Jumner/cubicFirmware/README.md

# Cubic

This is the repo where I store the code for Cubic. I'm using this README to document my process and share some of the engineering challenges I went through. So what is Cubic? Inspired by [Cubli](https://www.youtube.com/watch?v=n_6p-1J551Y), it is a cube that can balance on a corner or edge by spinning reaction wheels. Though it balances on the corner, there is always room to make it more robust. If I come back to this project, I will definitely do it right with Simulink, ROS and a chip with more than 2kb of ram. Also for the record, it doesn't jump up like the original, that would require a complete redesign.

<p align="center">
<b>Render<b>
render
VS
reality
<b>Reality<b>
</p>

## Viability Analysis (July 2021)

Before starting, I recognized that this was not going to be easy. I normally don't consider completion in software projects since the risk is zero. But if I'm buying hardware, I don't want it wasted when I could have done some basic math. So I started with some basic inverted pendulum equations and started playing with the values. How long should the sides be? How much torque does it need? How much inertia do my wheels need? Well, I defined these all as a function of side length. The torque due to gravity is proportional to mass and length or roughly length to the fourth. This incentives smaller cubes. With this in mind I wanted something around the 100-200mm range so I started at some motors, to see if I could find some with enough torque. After looking around and doing some math, I came to the conclusion that I could realistically pull this off.

### The Motors (August 2021)

I found Nidec24h Motors on eBay. They have fairly high rpm, high torque, built in tachometers, built in drivers. Knowing smaller cubes are better, I ran some numbers on the smallest cube I thought I could make with some rough estimates and found that it should work. Awesome! Let's get designing.

<p align="center">
Nidec24h BLDC Motor</p>

## Mechanical Design (October 2021)

With my motors picked, I started on the CAD. It was entirely designed with Fusion360 and I started by laying the motors out so they were basically touching. From there, I made the wheels so that they were almost touching (larger wheels is more inertia == higher impulse before the motors reach their peak rpm). I surrounded the wheels with a 150mm frame box. From there I made the motor mounts. I found that they all intersected with each other since the wheels are so large. So I decided to make an inner frame and outer frame. Kind of like a tesseract shape. This was a really great decision. Here you can see a basic design I made before picking the motors and one from before I increased the wheel size. I then added the white TPU bumpers which increased the size to 155mm.

<p align="center">
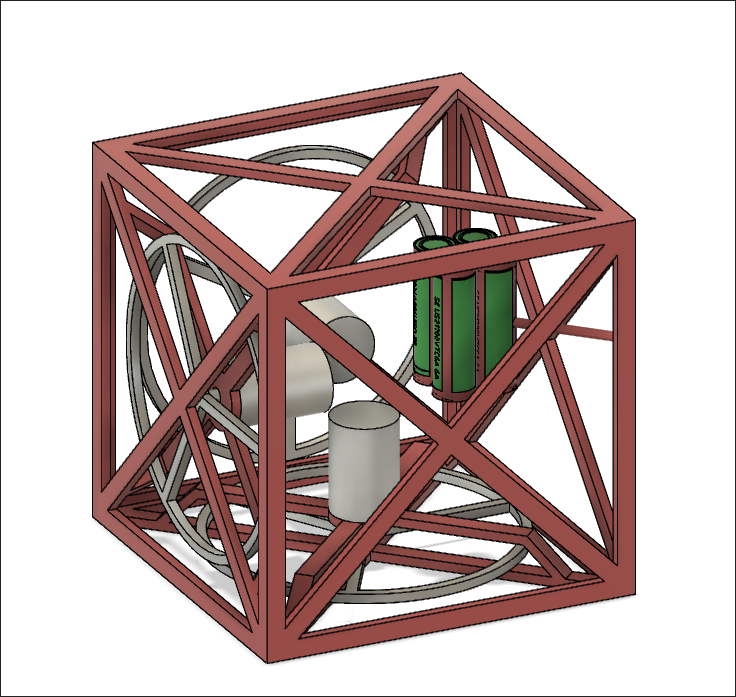
[picture p1: images/redbox.png]
Early render

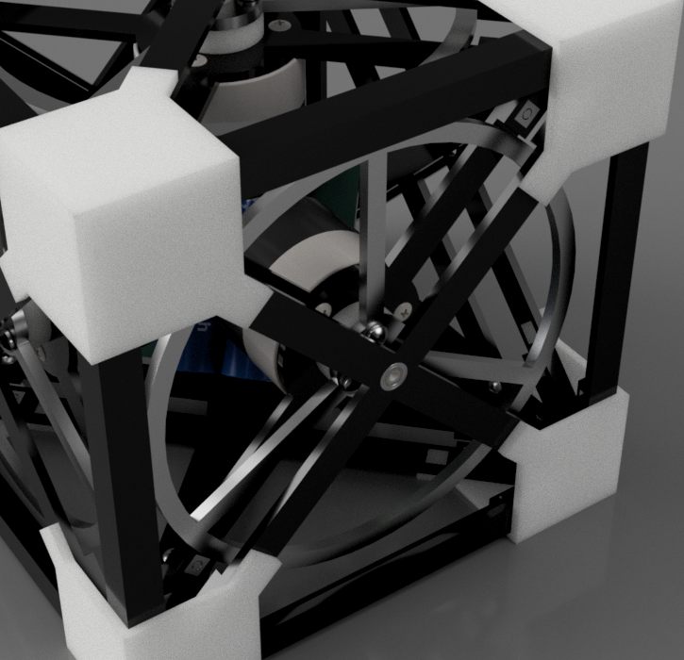
[picture p2: images/earlyrender.png]
More fleshed out render

</p>

### Wait 155mm??

Hold on a second... I plan on 3d printing this since that's the only manufacturing technique I really have. The problem is that my 3d printer has a print volume of 120mm x 120mm x 120mm. So I need to design this thing so that no part is larger than that.

The way I accomplished this is by splitting it into a bunch of parts with dovetails and fasteners. The inner frame is thankfully barely smaller than 120mm so those can be printed in one peice. Then I made these intricate corner pieces that bolt to the inner face, have each half edge click on, and have each face click on (with additional bolts). I then made these TPU covers for damping as I knew it would fall a lot. They also cover up the ugly corner joints. Here you can see the final design. A lot of time went into this, the final design in CAD is over 100 revisions.

<p align="center">
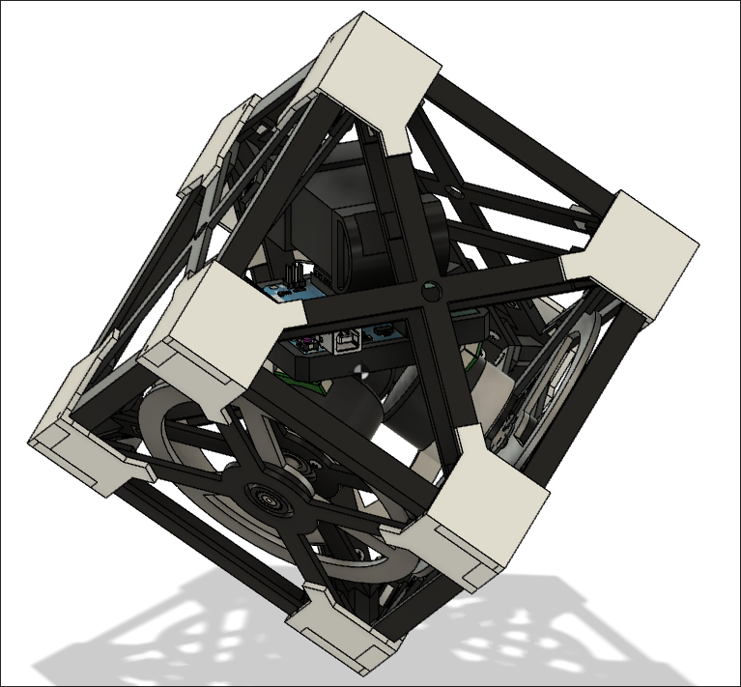
[picture p3: images/finaldesign.png]
Final design

</p>
You can see the complexity in these corner parts.
<p align="center">
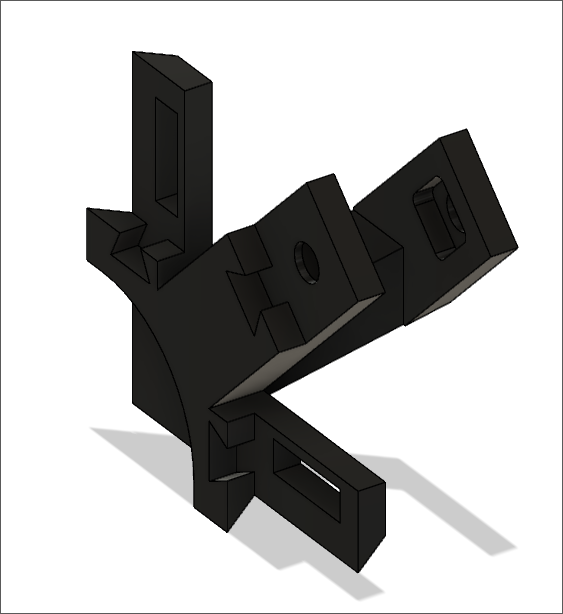
[picture p4: images/cornerpeice.png]
Corner piece

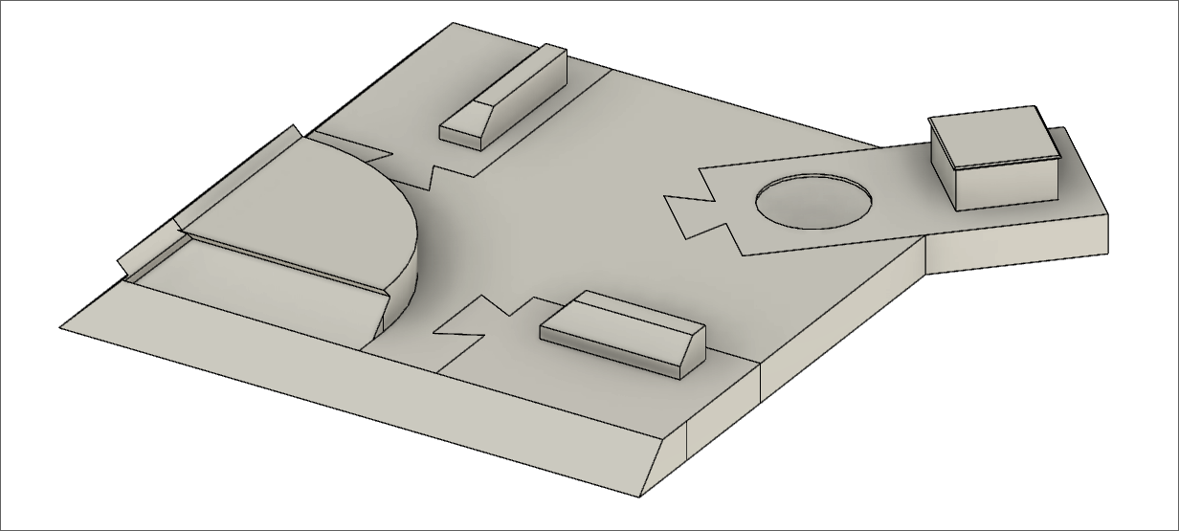
[picture p5: images/tpubumper.png]
TPU Bumper

</p>
And you can see how everything fits together to make a functional corner here.
<p align="center">
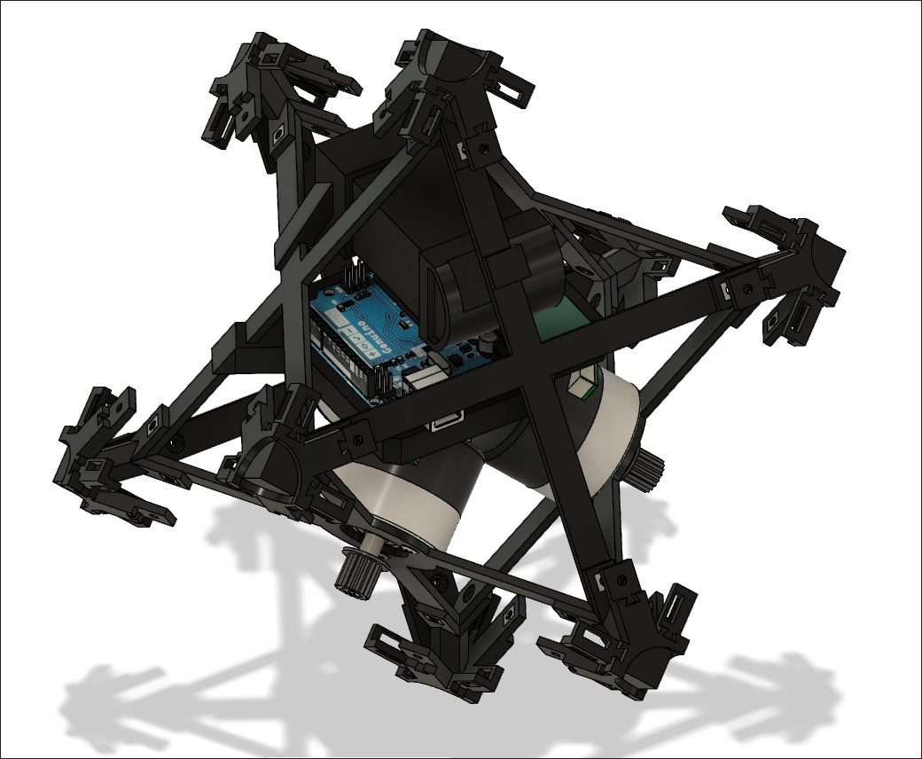
[picture p6: images/innercore.png]
Inner core assembly

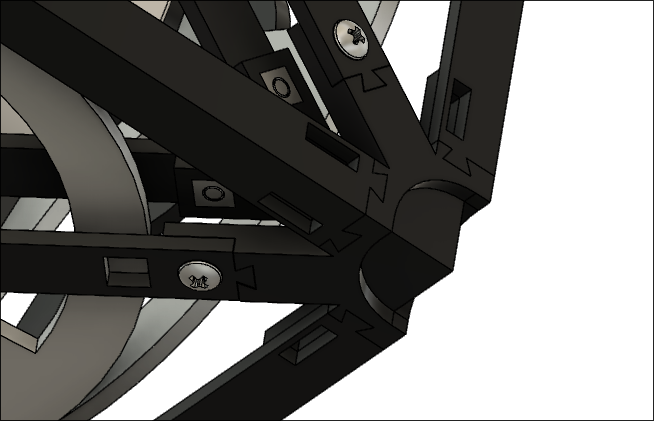
[picture p7: images/cornerassembly.png]
Corner assembly

</p>

### Nothing Ever Goes to Plan

I thought about having a small bearing click onto the end of the shaft so the motor and wheels are supported at 2 points, improving rigidity and reducing vibrations. However, there is a problem. I don't have my motors yet and I'm not sure if my motors have the pulley attached or if they just have the bare shaft. If they have the pulley, it is not going to work. Well, I took a gamble and started printing. Once the motors arrived, they had the pulleys which were intersection fit on and not coming off. I switched gears and reprinted the face so it would support the pulleys and remade the wheel mount. This was not ideal but it seemed to work.

### The Wheels (November 2021)

Once I did some more calculations and realized the wheels needed MUCH more inertia, I made them thicker and got them plasma cut out of 304L stainless steel at a local shop. These were perfect and make the project look so much more professional.

#### The Wheel Mounts

After discovering that the motors have pulleys, I designed a part to fit onto the pulley. The problem is that the tolerances to create a slip fit quickly wear and become loose. In hindsight, the holes could have been made undersized and inserted with the help of a heat gun. I ended up using white glue and tape to hole them in place. Far from ideal.

### Final Assembly (December 2021)

Now that I finally had all the parts, I could actually assemble them together! This when it started to feel real. It was super validating to see the mechanical design work out.

<p align="center">
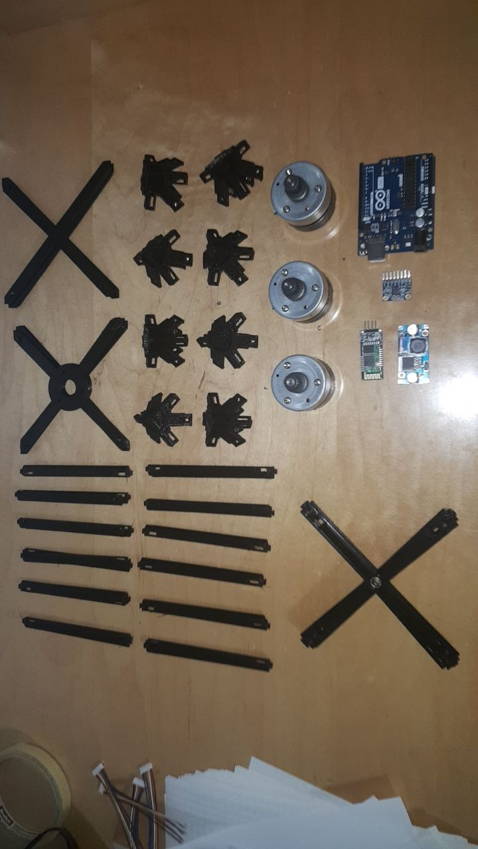
[picture p8: images/parts.jpg]
Parts

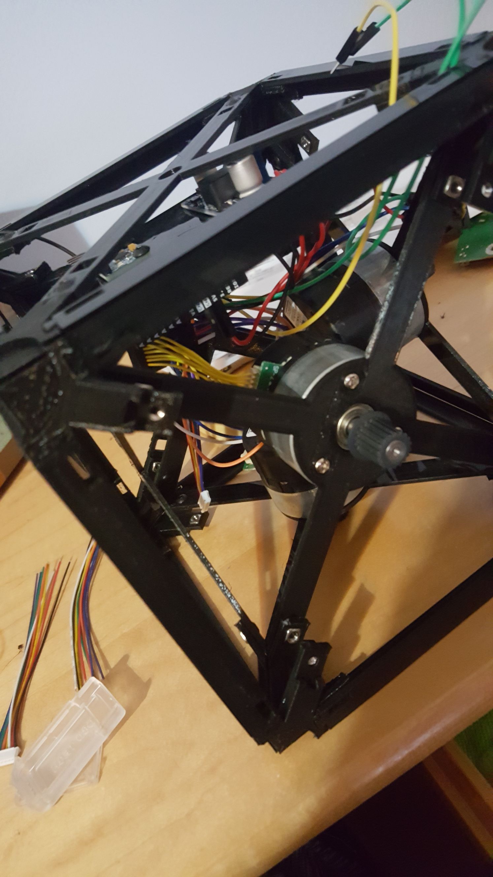
[picture p9: images/finalassemblynowheels.jpg]
Assembly with no wheels

reality
</p>

#### Happy Accidents

When I designed it, the corners would be glued together and it would be disassembled by unbolting everything. What I found is that Each face can stay together and all the faces can click together using the alignment features I put in the corners for gluing. This is far better in every possible way. A neat side effect is that my damping and decorative corner pieces now have the structural task of holding all the faces together. This makes servicing it super easy, just pop off 4 corner covers, pop 4 corners apart and removed just one face. The rest stay together. This is a great system and I got really lucky that I designed it in a way that allowed for this.

## Electronics

### The Printed Circuit Board Incident (September 2021)

The first real "failure" of the project (if you must call it that). I wanted to make my own circuit board as I have wanted to learn how to do that for some time. So I picked a chip (esp32) and spent a week reading datasheets, making the schematic and laying out the board. It included everything I needed including the MPU6050 inertial measurement unit that I would use to measure angles. So I ordered the boards and their components. I souldered the board and realized that even though I made extra sure the PCB traces could support the currents, I completely overlooked the power ratings of the components in my power supply circuitry. However, at least I could detect the chip from my computer, which was where I expected the board to fail. Regardless, this was not going to work.<br>

<p align="center">
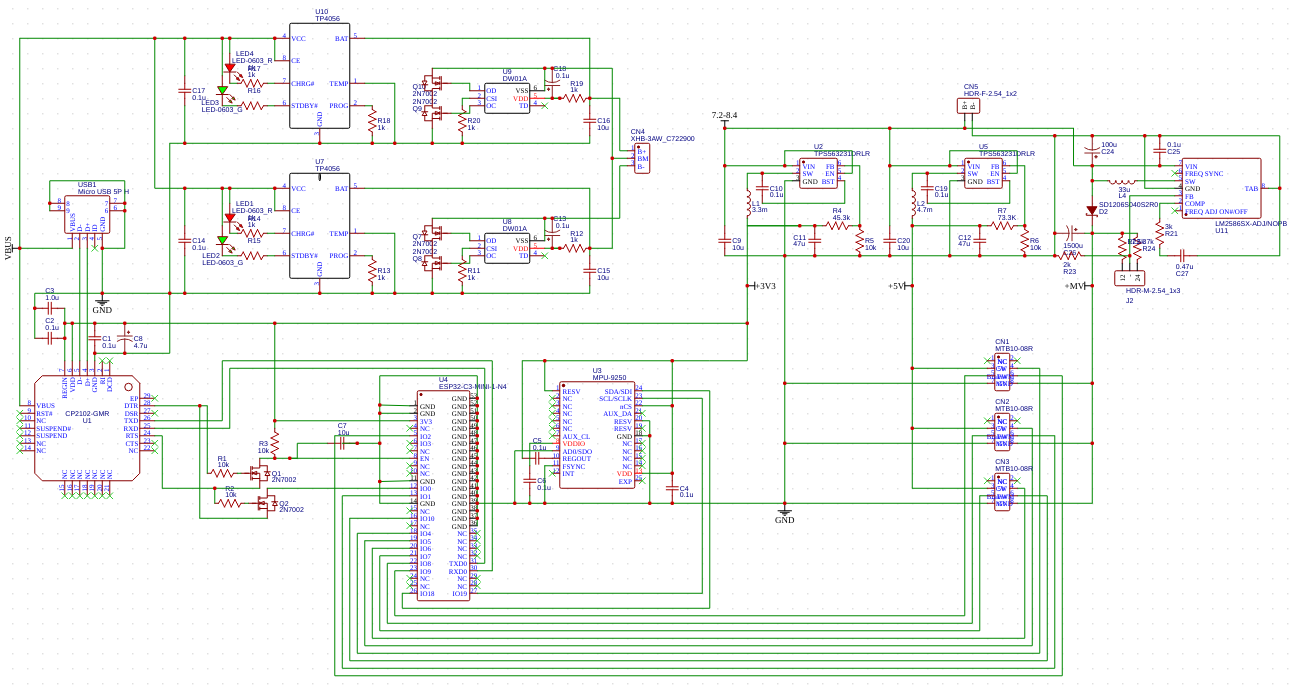
[picture p10: images/schematic.png]
PCB Schematic

</p>
<p align="center">
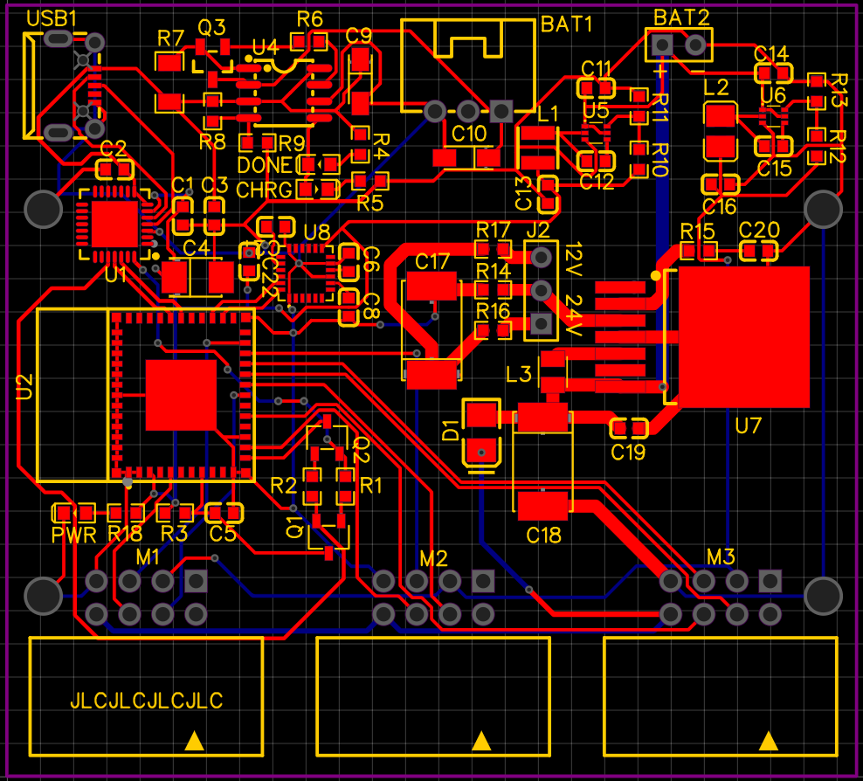
[picture p11: images/pcb1.png]
PCB layout

Final board
</p>
<br>
I should have realized just by looking at it that the components were too small (look at those tiny components in the top right of the board). Regardless, it was an amazing experience and I learned so much about electronics.

### Plan B

After my custom PCB went up in smoke (No, literally), I pivoted to using an Arduino Uno I had on hand. I then ordered a battery, step down buck converter, and an MPU6050 (mine was on the board remember?).

Using these I got the motors spinning after a quick panic about how the 12 or 24v motors accept EITHER 12 or 24 not a range so my old 18v laptop power supply would not work. After creating the now inevitable mess of wires, I had everything talking to the Arduino.

## Software

Wow! I've done so much! I must be at least halfway done right? Right? I just have to write some code. How hard can it be? Well with all the planning I did with the hardware, I did not once consider that maybe I should plan out the software too. Unfortunately this was my biggest mistake and probably one of the biggest lessons I learned, after all it cost me nearly 2 years of struggling when I could have spend a week planning.

Here begins a 2 year long game of guess and check.

### Rust (November 2021)

I love Rust. It's an amazing language. I wont even diss it here because I learned an incredible amount about embedded programming and microcontrollers in the week it took me to get I2C, PWM, and interrupts working (things that are a few lines of code in arduino). The problems came because the atmega328p does not have enough hardware interrupt pins for my 3 tachometers, and IMU (an interrupt was needed for the mpu6050s Digital Motion Processor which I ended up not using). Arduino just pretends it's fine and it somehow works. I have no idea what black magic Arduino does to get this to work but I gave up on Rust.

### Start with an Edge (January 2022)

Instead of jumping into balancing on the corner, I made the correct decision to start with the edge and use what I learned for the corner. However, this was no easy task and took months on its own.

<br>
<p align="center">
Cubic balancing on its edge
</p>

### Bottomless Pit of Controls (January 2022 - July 2023)

It was at this point that I started getting close, I experimented with everything I possibly could given the scope. The real problem was my uncertainty caused by the inability to collect data. If I could analyze data it would probably have taken me a tenth of the time. This is the endless game of guess and check I mentioned earlier. I took lots of breaks (including all of first year) and would come back with fresh ideas in my heads to finally get it balancing for real this time. The real demon here is the silicon shortage as I could not get a Pi zero 2. If I could, I could run ROS2 on it and get actual data. However, the best I could do is just run a serial cable directly and hope the cable doesn't affect its behaviour too much.

## The Journey of System Architecture

This was a long path of slowly finding the correct algorithms and discovering constraints I had no idea existed. Here are all the major systems and the path I took to arive at them.

### Big Picture System Architecture

```mermaid
stateDiagram-v2
    direction LR
    
    kalman: State Estimator
    ff: Feed Forward
	il: Input Linearization
    plant: Plant
    plus: +
    Disturbances --> plant
    Disturbances --> ff
    ff --> plus : u
    plus --> il : u
	 il --> plant : PWM commands
    
    PID --> plus : u
    plant --> kalman : y
    kalman --> PID : x
```

### State Estimation
#### Kalman Filter
I knew about Kalman filters and I was already planning on a state space based approach so it made sense. I quickly discovered that there was not enough ram or storage space to store the matrices needed. This was a crushing blow and was also not the first or last time the Atmega328p caused me headaches in this project. So I ended up settling on a pretty basic filter where it calculates the estimated position based on the state space model, then weighs each state independently to make some smoother and some more responsive. My lack of data means I don't know if states are responsive enough or too noisy. I just manually tuned it until each state was responsive enough to not cause noticeable problems.
#### Measuring the Angle
Measuring the angle is not straightforward as the MPU6050 only measures angular rate and acceleration. For a while I used the accelerometer readings to find the gravity vector but after moving the sensor for the 3d configuration, there was too much noise to use the sensor. A heavier filter didn't work as it was not responsive enough to account for the high frequency disturbances not captured by the model. The other problem is that that measurement is only a reference as 0 degrees is not the exact balance point in practice. So you need some kind of set point adjustment regardless of if you measure the angle or not.

### Input Linearization and Feed Forward Control

My goal with getting this project working is to eliminate as much non-linear behaviour as possible. Though this is good in spirit, it introduced a lot of bloat and uncertainty and I'm unsure how much it really benefited the project.

I knew the torque of the motors was dependent on the wheel velocity. So I ran the motor with the wheel from backwards at full rpm to forwards at full rpm. Since the motors have tachometers, I know the exact speed of the wheel. So I can use the acceleration of wheel inertia from the CAD to find the torque of the motor as a function of the current motor velocity and the current 0-1 PWM input. From there I can find the PWM input as a function of desired torque and current velocity. This removed a big non-linearity from the project.

As for feed forward control, I found the concept really interesting so I want to apply it. I could easily calculate the force of gravity and remove it from the system by adding it to the torques after the PID step. This is a waste because inverted pendulums are highly locally linear. There is also a possibility that the instability is caused when the cube tilts while the wheels are spinning quickly and it imparts a gyroscopic effect that the controller can't cope with. If this is the case, then adding feed forward control to cancel out the gyroscopic effect could be beneficial. I would need to pour over the data to confirm this.

### Control Systems

#### LQR to PID

After learning that there were control algorithms other than PID, I was hooked and started learning about LQR from the amazing resources made by Brian Douglas and Steve Brunton. I started learning all about state space models and how linear optimal control works. So of course I tried to implement it in this project but unfortunately, it wasn't very good at all. I realized I probably needed a more novel algorithm and so I turned back and went with a PID based approach. This was by no means a waste as the state space model I developed is still used for the state estimation. Plus I learned a ton.

#### Finding The Set Point

Because this is a balancing robot, the set point is critical to success.

A clever technique is to notice that if you are on the wrong side of your balance point, your wheels are going to spin up. Since we can measure wheel velocity, we can use that to move the set point. I essentially use a PI controller for this. It has one term that moves the set point proportional to the wheel velocity for a quick response, and one term that uses the integral of the wheel speed to improve robustness. I believe it is this system that is the cause of the instability. Again, I would need good data to confirm this.

#### Gradient Descent Gain Tuner

Because I am using a PD controller with a PI set point adjust controller, I have 4 gains and tuning those by hand proved impossible. So I wrote a Julia script that uses a nonlinear model and a simple gradient descent algorithm to find the best gains for a given cost function. This was a great decision and the gains found by the script really did work on the real thing. This is what makes me question if gyroscopic effects are involved as they were not part of the nonlinear model. 

### Issues Moving to 3D

When balancing on the corner, there are 2 angles (x,y or forwards/backwards and left/right) and 3 wheels. When it was on the edge, wheel rate is used by the controller. This breaks when going for the corner because the 2 angles must share the 3 wheels. Each state cannot have its own wheel. This seemed difficult until I realized it was just a simple transformation matrix. I just pass in the 3 wheel velocities, and out comes the 2 virtual wheel velocities with respect to each axis. The inverse of this matrix is used to turn the 2 torque commands from the controller into 3 torque commands for the 3 wheels.

## Unstable Success

Though it only balances for a few seconds before accidentally throwing itself into an unrecoverable situation, this is a huge success. I came into this project to see my own creation balancing on its corner using hardware I designed and manufactured, running software I wrote. All I can say is mission accomplished. I did what I set out to do and it is so unbelievably satisfying. I grew as a not only as an engineer but as a person through this project and I am so glad I did it. Will I return to this project with the goal of rock steady stability? Only time will tell. But if I do, you bet I'll do it right with the lessons I've learned so far. Far well, Cubic.<br>

<p align="center">
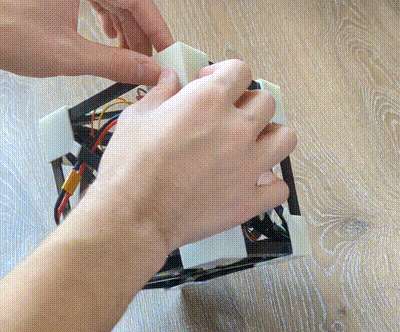
[picture p12: images/cornerbalance.gif]
Cubic balancing on its corner

</p>

## What I Would Do Next Time

If I did this project all over, aside from reading the specs of my PCB components, I would plan out the software better. I didn't even have to consider everything. Just enough to guide me would have made it 100x better. Some basic research on which control algorithm I would use, how I would model it. How I would collect data (and yes you need data). I needed to simulate it in simulink (which for the record, I didn't have access to at the time) to make sure it works. All of this would have made it a much smoother and more robust process.
