Jumner/cubicFirmware/images/pcb2.png

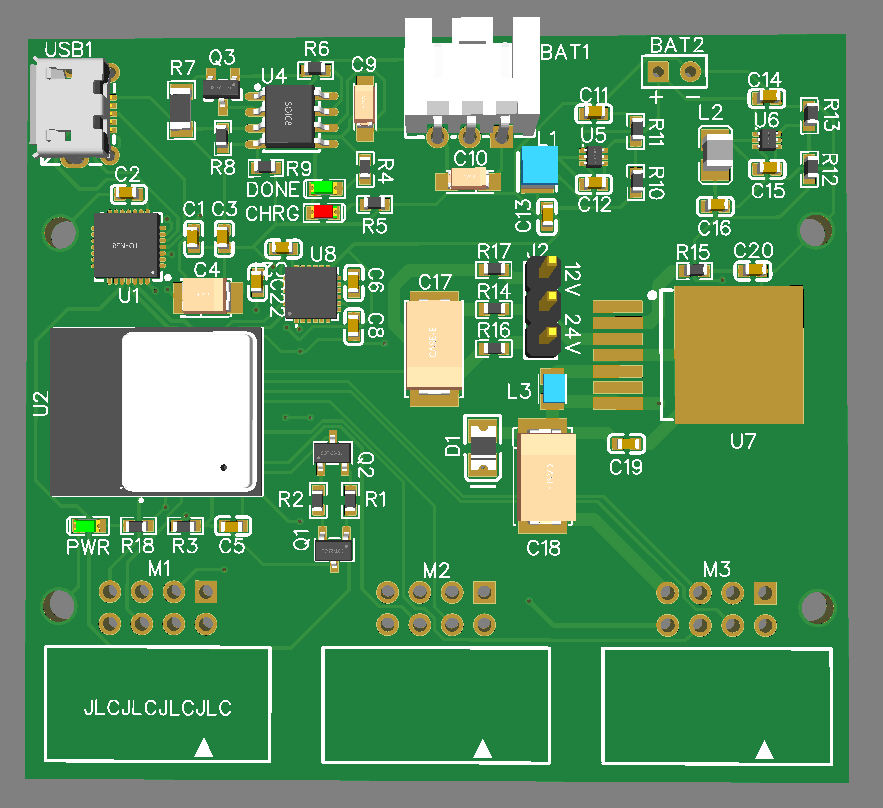
images/pcb2.png
