Jumner/cubicFirmware/images/v1Render.png

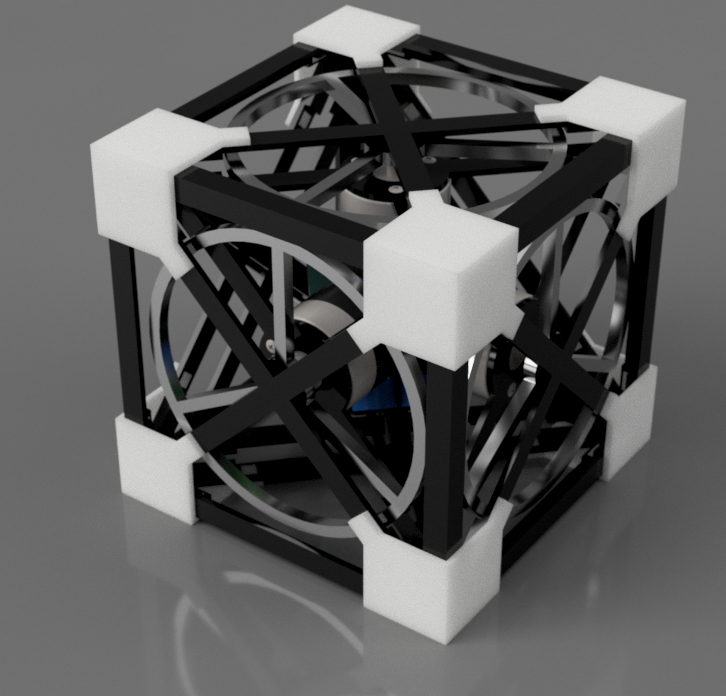
images/v1Render.png
