Jumner/cubicFirmware/(commit log)

2021-11-25 Finshed pwm on all pins
2021-11-25 test input interrupt
2021-11-26 setup interrupt registers
2021-11-26 omg Interrupts work
2021-11-27 setup tacks and motors
2021-12-04 messed with imu
2021-12-05 done sensor
2021-12-07 changed dir so arduino can tell me size
2021-12-07 removed all ricotta (it went moldy)
2021-12-08 working on kalman filter
2021-12-09 recalibrated imu
2021-12-09 signed measured wheel speed
2021-12-11 bruh mem
    [data.csv]
2021-12-11 not working just yet
    [Cubic.cpp, Motor.cpp, Motor.h, main.ino]
2021-12-13 more troubleshooting
    [final.csv]
2021-12-14 calibration stuff
2021-12-15 done calibration
2021-12-22 working on all motors
2021-12-23 big issues should be fixed
    [Cubic.cpp, Cubic.h, Motor.cpp, main.ino]
2022-12-28 Phase 2 - Rearanged everything
    [data.csv, final.csv]
2023-05-03 wrong file got edited
    [Cubic.cpp, Cubic.h, Motor.cpp, main.ino]
2023-05-07 time to tune PID
2023-08-10 Fixed a quick bug
    [Motor.cpp, Motor.h, main.ino]
2024-01-12 Cropped pcb image to look better
2024-01-13 Fixed pcb image in README.md
